AlexKokoschka/StepMother/v1-teensy/enclosure/design-your-own/StepMother1_Teensy_FitCheck.step

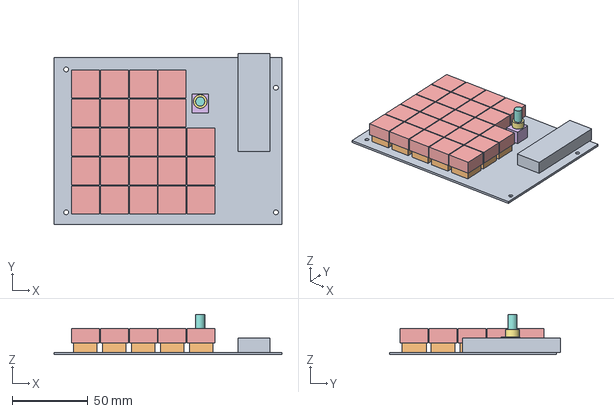
[picture p1: CAD file, 2026-11-03]
v1-teensy/enclosure/design-your-own/StepMother1_Teensy_FitCheck.step
150.0 x 112.5 x 26.6 mm
