AlexKokoschka/StepMother/v1-teensy/enclosure/print/StepMother1_Teensy_BottomPlate.step

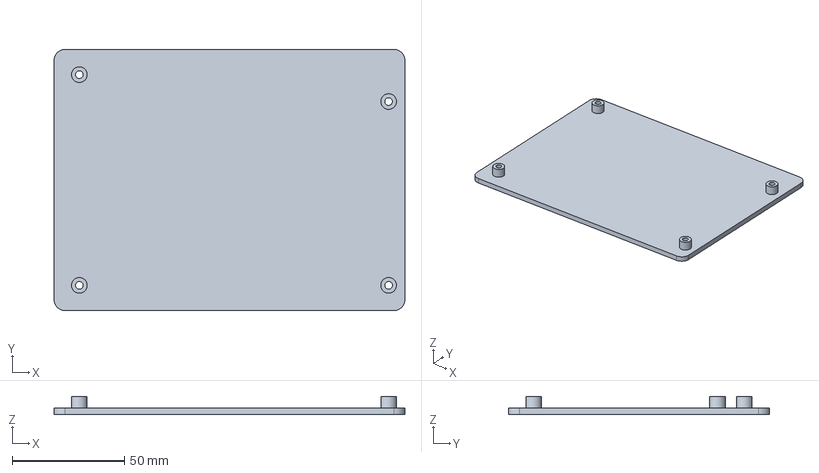
[picture p2: CAD file, 2026-11-03]
v1-teensy/enclosure/print/StepMother1_Teensy_BottomPlate.step
156.6 x 116.6 x 8.20 mm
