AlexKokoschka/StepMother/v1-teensy/enclosure/source/StepMother1_Teensy_Enclosure.FCStd

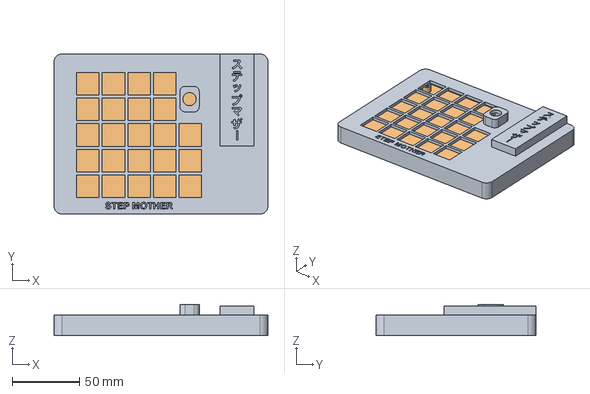
[picture p3: CAD file, 2026-11-03]
v1-teensy/enclosure/source/StepMother1_Teensy_Enclosure.FCStd
159.0 x 119.0 x 23.1 mm
BottomPlate
