AlexKokoschka/StepMother/v1-teensy/pcb/3_documentation/StepMother1_3D_2026-11-01.step

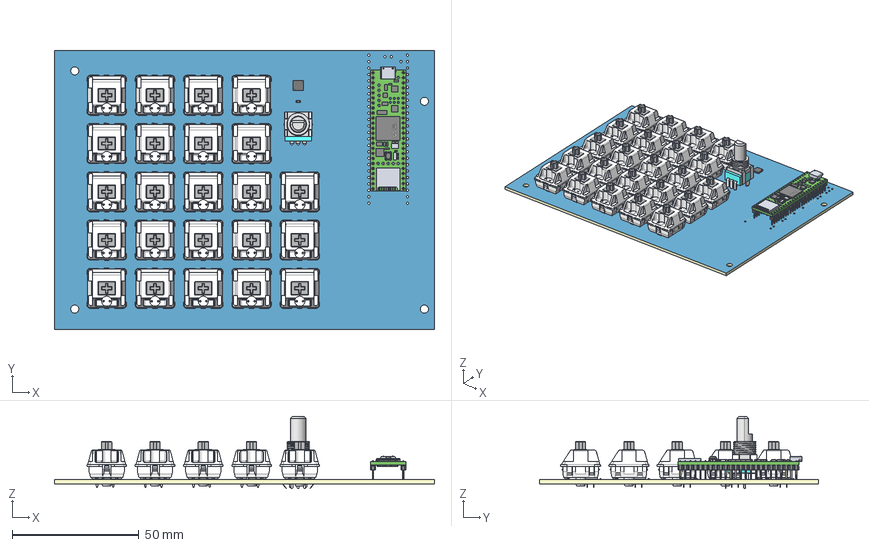
[picture p4: CAD file, 2026-11-03]
v1-teensy/pcb/3_documentation/StepMother1_3D_2026-11-01.step
150.0 x 110.0 x 28.5 mm
Board~ziuG
TopCopper~ziuG
BottomCopper~ziuG
TopSilkscreen~ziuG
BottomSilkscreen~ziuG
TopFpcStiffener~ziuG
BottomFpcStiffener~ziuG
R0603~R0603~ziuG
SOD-123_L2.7-W1.6-LS3.7-FD~SOD-123_L2.7-W1.6-LS3.7-FD~ziuG x 23
QFN-28_L4.0-W4.0-P0.40-BL-EP~QFN-28_L4.0-W4.0-H0.9-P0.40-BL-EP~ziuG
LED0402-R-RD~LED0402_L1.0-W0.5-H0.4~ziuG x 20
RES-ADJ-TH_RK09L1140A5P~RES-ADJ-TH_RK09L1140A5P~ziuG
KEY-TH_CPG151101D06~KEY-TH_CPG151101D06~ziuG x 23
TEENSY4.1 - KB~COMM-TH_TEENSY4.1COPY~ziuG
