AlexKokoschka/StepMother/v2-rp2040/enclosure/source/StepMother2_RP2040_Enclosure.FCStd

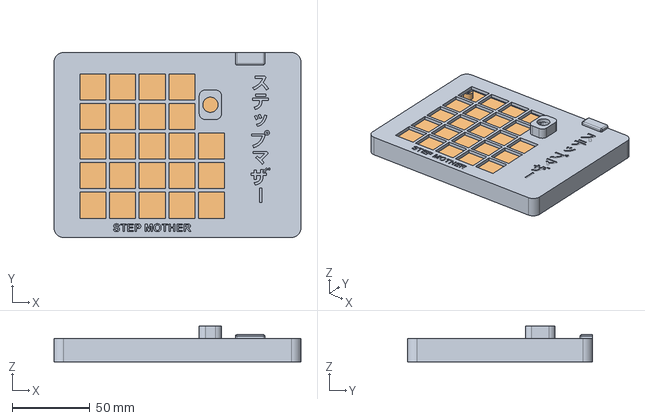
[picture p5: CAD file, 2026-11-12]
v2-rp2040/enclosure/source/StepMother2_RP2040_Enclosure.FCStd
159.0 x 119.0 x 23.1 mm
BottomPlate
