AlexKokoschka/StepMother/v2-rp2040/pcb/3_documentation/StepMother2_3D_2026-11-12.step

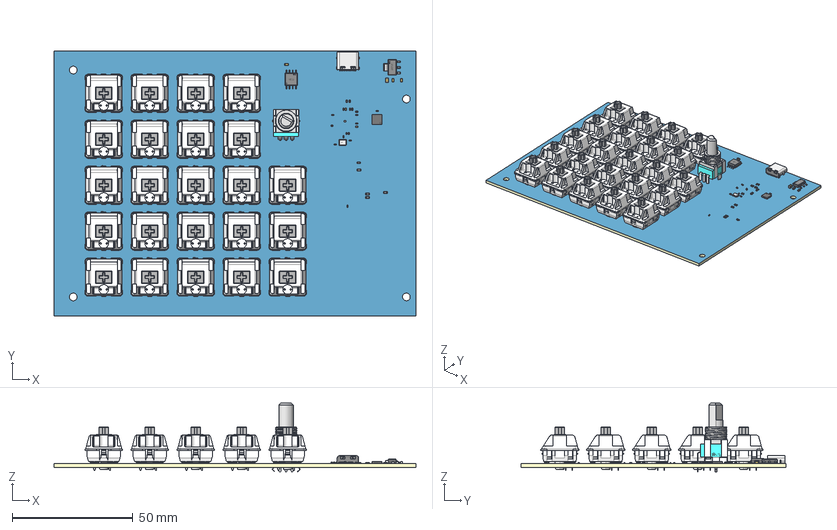
[picture p6: CAD file, 2026-11-12]
v2-rp2040/pcb/3_documentation/StepMother2_3D_2026-11-12.step
150.0 x 110.0 x 28.5 mm
Board~VF1d
TopCopper~VF1d
BottomCopper~VF1d
TopSilkscreen~VF1d
BottomSilkscreen~VF1d
TopFpcStiffener~VF1d
BottomFpcStiffener~VF1d
LQFN-56_L7.0-W7.0-P0.4-EP~LQFN-56_L7.0-W7.0-P0.4-EP~VF1d
KEY-TH_CPG151101D06~KEY-TH_CPG151101D06~yfCF x 23
C0603~C0603_L1.6-W0.8-H0.8~tLiC x 3
C0805~C0805_L2.0-W1.3-H1.3~WK5H
LED0402-R-RD~LED0402_L1.0-W0.5-H0.4~oqK9 x 20
SOD-123_L2.7-W1.6-LS3.7-FD~SOD-123_L2.7-W1.6-LS3.7-FD~p6Gi x 23
C0402~C0402_L1.0-W0.5-H0.5~t2Ha x 15
R0603~R0603~kR0k x 5
R0402~R0402_L1.0-W0.5-H0.4~Sbx4 x 4
CRYSTAL-SMD_4P-L3.2-W2.5-BL~CRYSTAL-SMD_4P-L3.2-W2.5-BL~g01I
SOT-223-3_L6.5-W3.4-P2.30-LS7.0-BR~SOT-223-4P_L6.5-W3.5-H1.6-LS7.0-P2.30~qlD3
USB-C_SMD-TYPE-C-31-M-12_1~USB-C_SMD-TYPE-C-31-M-12_1~Xcjv
RES-ADJ-TH_RK09L1140A5P~RES-ADJ-TH_RK09L1140A5L~RHhM
SOIC-8_L5.3-W5.3-P1.27-LS8.0-BL~SOIC-8_L5.3-W5.3-H1.9-LS7.9-P1.27~I64y
QFN-28_L4.0-W4.0-P0.40-BL-EP~QFN-28_L4.0-W4.0-H0.9-P0.40-BL-EP~uROi
