AlexKokoschka/StepMother/v1-teensy/enclosure/print/StepMother1_Teensy_Shell.step

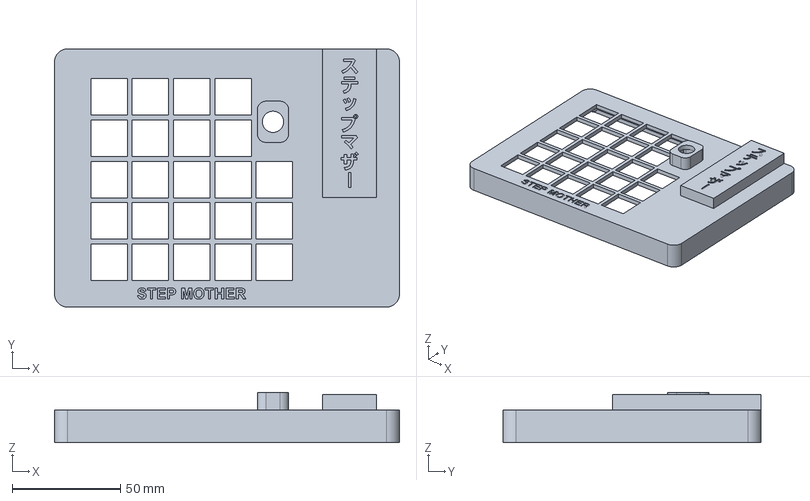
[picture p7: CAD file, 2026-11-03]
v1-teensy/enclosure/print/StepMother1_Teensy_Shell.step
159.0 x 119.0 x 23.1 mm
