AlexKokoschka/StepMother/v2-rp2040/enclosure/print/StepMother2_RP2040_Shell.step

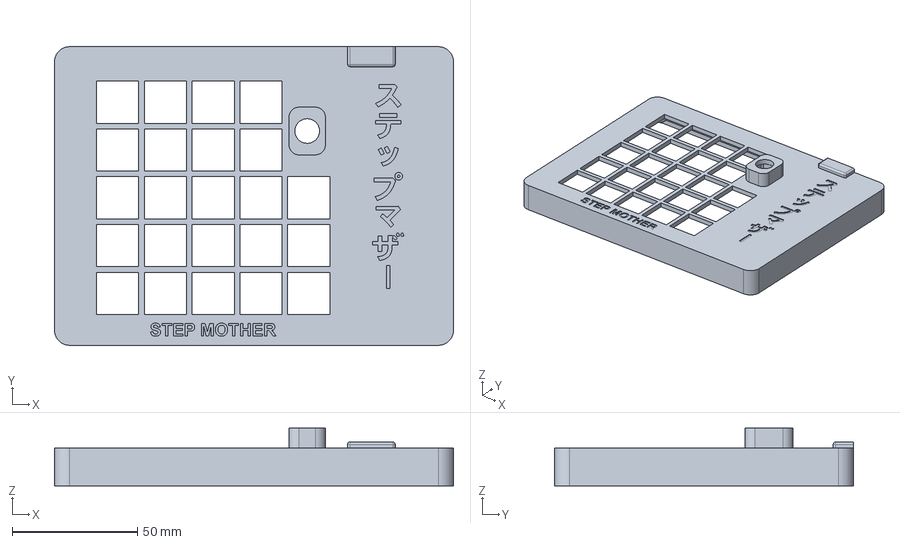
[picture p8: CAD file, 2026-11-12]
v2-rp2040/enclosure/print/StepMother2_RP2040_Shell.step
159.0 x 119.0 x 23.1 mm
