AlexKokoschka/StepMother/(list of files, cad)

Other CAD files:
v2-rp2040/enclosure/design-your-own/StepMother2_RP2040_FitCheck.step
v2-rp2040/enclosure/print/StepMother2_RP2040_BottomPlate.step
v1-teensy/enclosure/print/StepMother1_Teensy_BottomPlate.stl
v1-teensy/enclosure/print/StepMother1_Teensy_Shell.stl
v2-rp2040/enclosure/print/StepMother2_RP2040_BottomPlate.stl
v2-rp2040/enclosure/print/StepMother2_RP2040_Shell.stl
