AlexKokoschka/StepMother/v2-rp2040/pcb/3_documentation/StepMother2_PCB_Assembly_2026-11-12.pdf

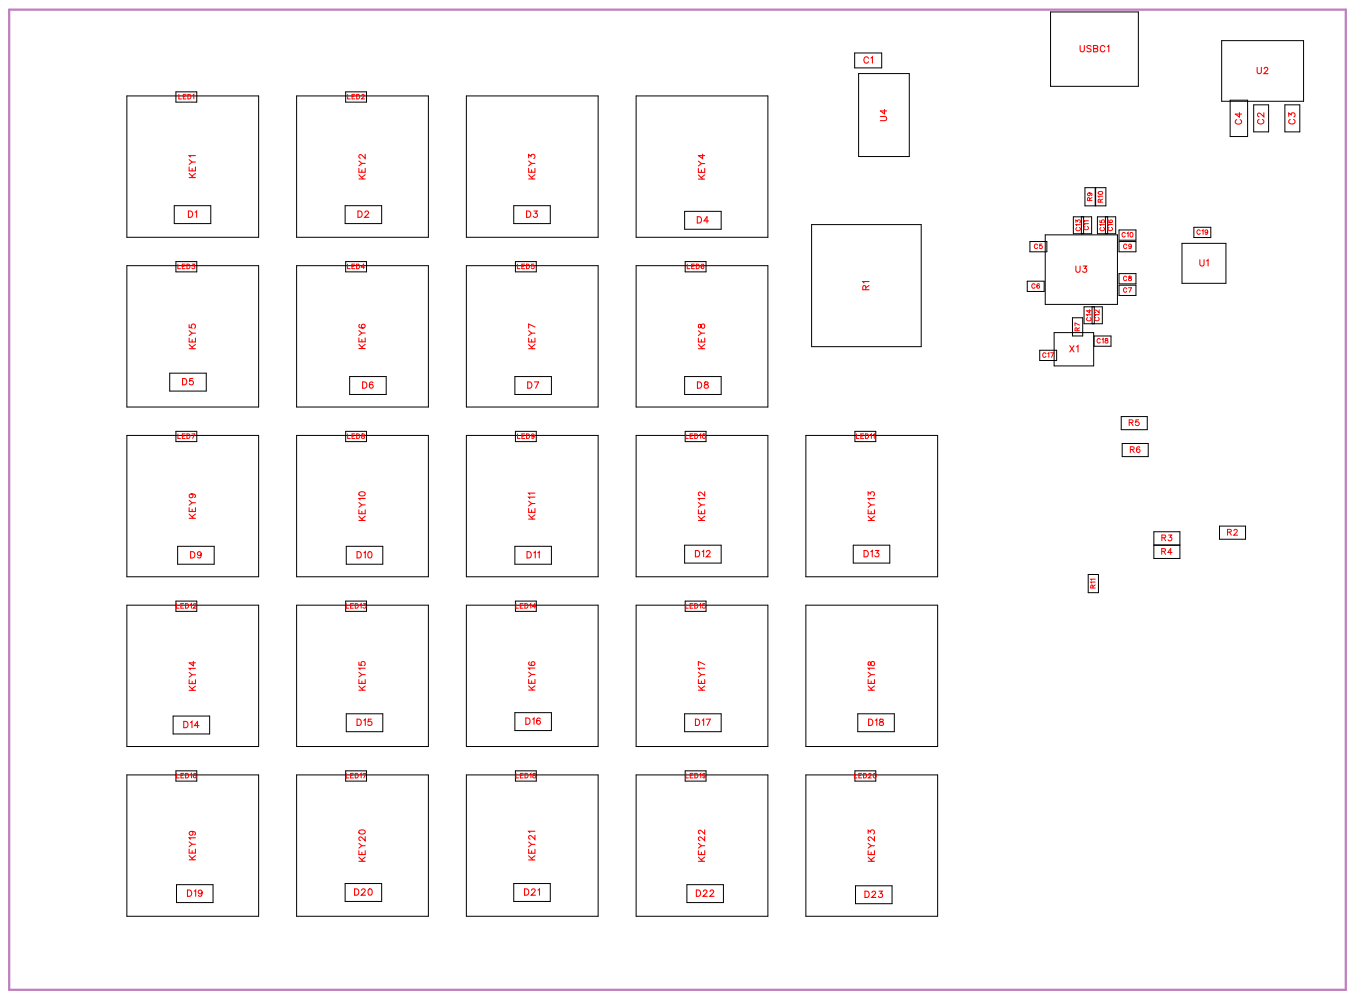
[picture p9: page 1]

No. | Quantity | Comment | Designator | Footprint | Value | Manufacturer Part | Manufacturer | Supplier Part | Supplier
1 | 1 | 100nF | C1 | C0603 | 100nF | CC0603KRX 7R9BB104 | YAGEO(国巨 ) | C14663 | LCSC
2 | 1 | 1uF | C2 | C0603 | 1uF | CL10A105KB 8NNNC | SAMSUNG( ) 三星 | C15849 | LCSC
3 | 1 | 10uF | C3 | C0603 | 10uF | CL10A106KP 8NNNC | SAMSUNG( 三星 ) | C19702 | LCSC
4 | 1 | 22uF | C4 | C0805 | 22uF | CL21A226M AQNNNE | SAMSUNG( 三星 ) | C45783 | LCSC
5 | 11 | 100nF | C5,C6,C7,C8,C9,C10,C11, C12,C13,C14,C19 | C0402 | 100nF | CL05B104K O5NNNC | SAMSUNG( 三星 ) | C1525 | LCSC
6 | 2 | 1uF | C15,C16 | C0402 | 1uF | CL05A105KA 5NQNC | SAMSUNG( ) 三星 | C52923 | LCSC
7 | 2 | 15pF | C17,C18 | C0402 | 15pF | 0402CG150J 500NT | FH(风华 ) | C1548 | LCSC
8 | 23 | 1N4148W | D1,D2,D3,D4,D5,D6,D7,D8, D9,D10,D11,D12,D13,D14, D15,D16,D17,D18,D19,D20 ,D21,D22,D23 | SOD-123_L2 .7-W1.6-LS3. 7-FD | | 1N4148W | HXY MOSFE T(华轩阳电子 ) | C5345962 | LCSC
9 | 23 | CPG151101 D06 | KEY1,KEY2,KEY3,KEY4,K EY5,KEY6,KEY7,KEY8,KE Y9,KEY10,KEY11,KEY12,K EY13,KEY14,KEY15,KEY16 ,KEY17,KEY18,KEY19,KEY 20,KEY21,KEY22,KEY23 | KEY-TH_CP G151101D06 | | CPG151101 D06 | HanElectricit y(瀚源 ) | C49234237 | LCSC
10 | 20 | YLED0402R | LED1,LED2,LED3,LED4,LE D5,LED6,LED7,LED8,LED9 ,LED10,LED11,LED12,LED 13,LED14,LED15,LED16,LE D17,LED18,LED19,LED20 | LED0402-R-RD | | YLED0402R | YONGYUTAI (永裕泰) | C21260817 | LCSC
11 | 1 | 10k | R1 | RES-ADJ-TH _RK09L1140 A5P | 10k | RK09L1140A 5L | ALPSALPIN E(阿尔卑斯阿 尔派 ) | C7419101 | LCSC
12 | 1 | 20k | R2 | R0603 | 20k | 0603WAF20 02T5E | UNI-ROYAL( ) 厚声 | C4184 | LCSC
13 | 2 | 4.7k | R3,R4 | R0603 | 4.7k | 0603WAF47 01T5E | UNI-ROYAL( ) 厚声 | C23162 | LCSC
14 | 2 | 5.1k | R5,R6 | R0603 | 5.1k | 0603WAF51 01T5E | UNI-ROYAL( 厚声 ) | C23186 | LCSC
15 | 1 | 1k | R7 | R0402 | 1k | 0402WGF10 01TCE | UNI-ROYAL( 厚声 ) | C11702 | LCSC
16 | 2 | 27 | R9,R10 | R0402 | 27 | 0402WGJ02 70TCE | UNI-ROYAL( 厚声 ) | C25156 | LCSC
17 | 1 | 10k | R11 | R0402 | 10k | 0402WGF10 02TCE | UNI-ROYAL( ) 厚声 | C25744 | LCSC
18 | 1 | IS31FL3731-QFLS2-TR | U1 | QFN-28_L4.0 -W4.0-P0.40-BL-EP | | IS31FL3731-QFLS2-TR | ISSI(北京矽 成) | C191206 | LCSC

19 | 1 | AMS1117-3. 3 | U2 | SOT-223-3_L 6.5-W3.4-P2. 30-LS7.0-BR | | AMS1117-3. 3 | Advanced Monolithic Systems | C6186 | LCSC
20 | 1 | RP2040 | U3 | LQFN-56_L7. 0-W7.0-P0.4-EP | | RP2040 | Raspberry Pi(树莓派 ) | C2040 | LCSC
21 | 1 | W25Q16JVS SIQ | U4 | SOIC-8_L5.3 -W5.3-P1.27-LS8.0-BL | | W25Q16JVS SIQ | Winbond( 华 ) 邦 | C131025 | LCSC
22 | 1 | TYPE-C-31-M-12 | USBC1 | USB-C_SMD -TYPE-C-31-M-12_1 | | TYPE-C-31-M-12 | 韩国韩荣 | C165948 | LCSC
23 | 1 | 12MHz | X1 | CRYSTAL-S MD_4P-L3.2-W2.5-BL | 12MHz | ABM8-272-T 3 | ABRACON | C20625731 | LCSC

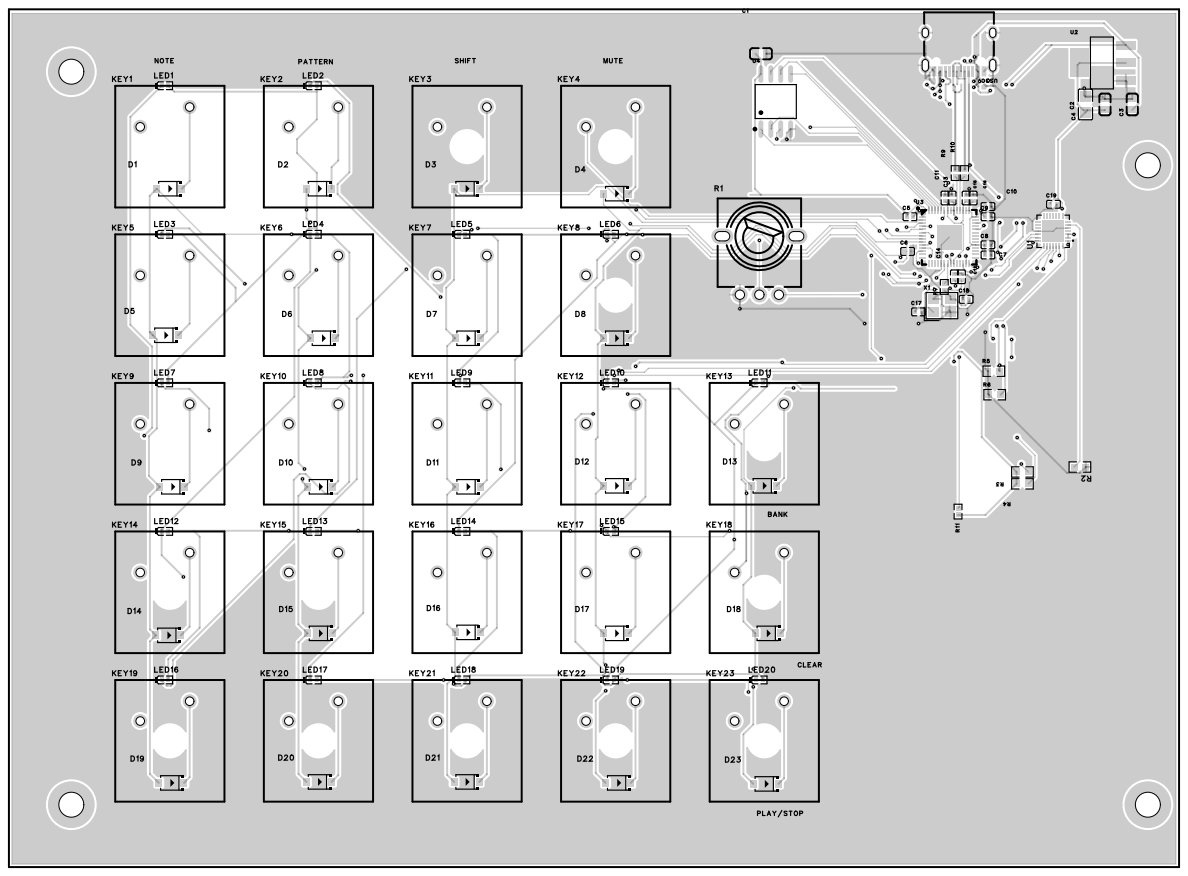
[picture p10: page 5]

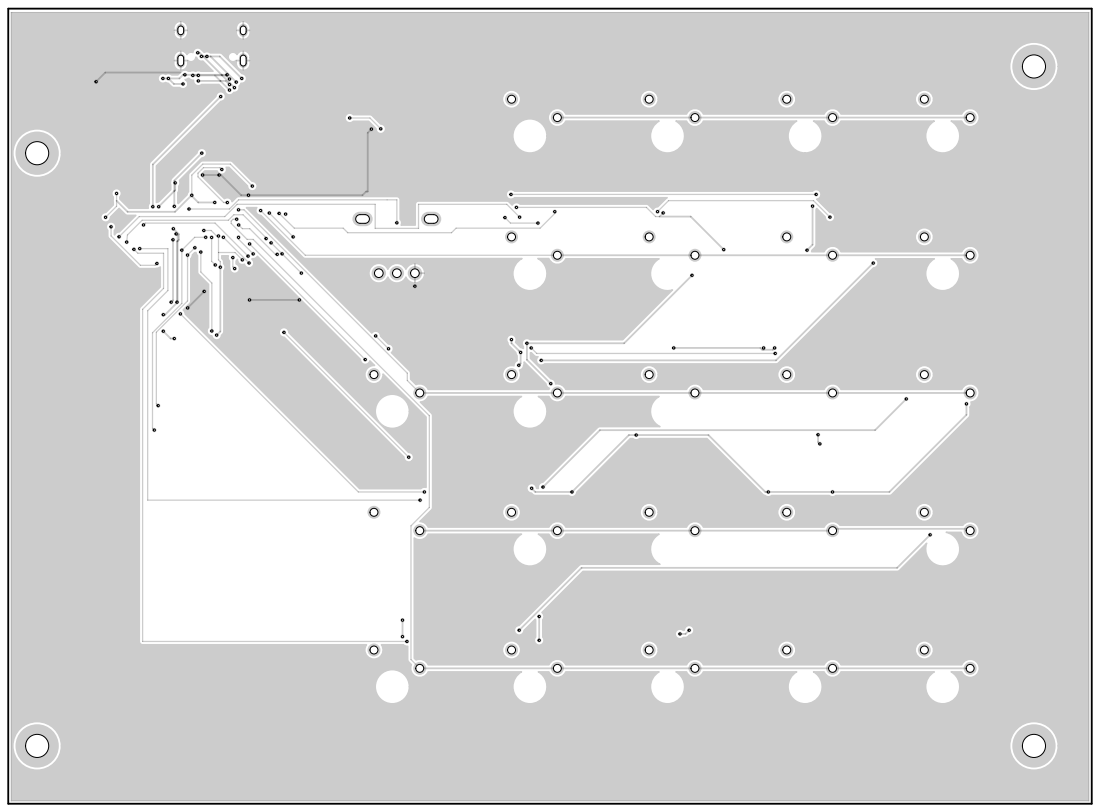
[picture p11: page 6]

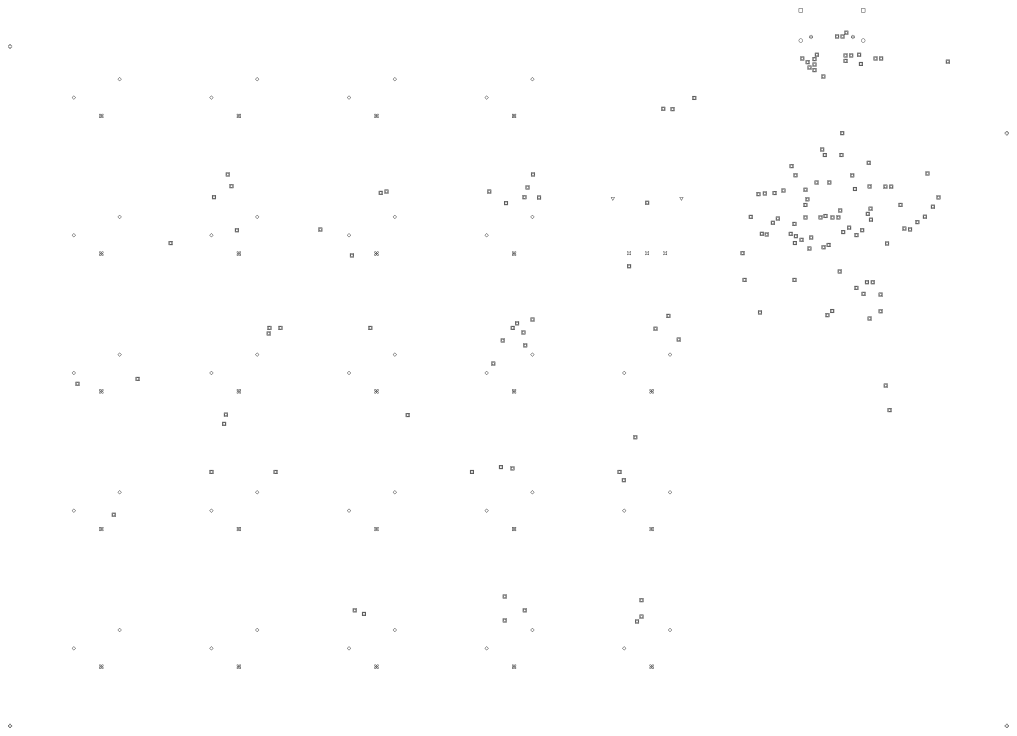
[picture p12: page 7]
