AlexKokoschka/StepMother/v2-rp2040/pcb/3_documentation/StepMother2_Schematic_2026-11-12.pdf

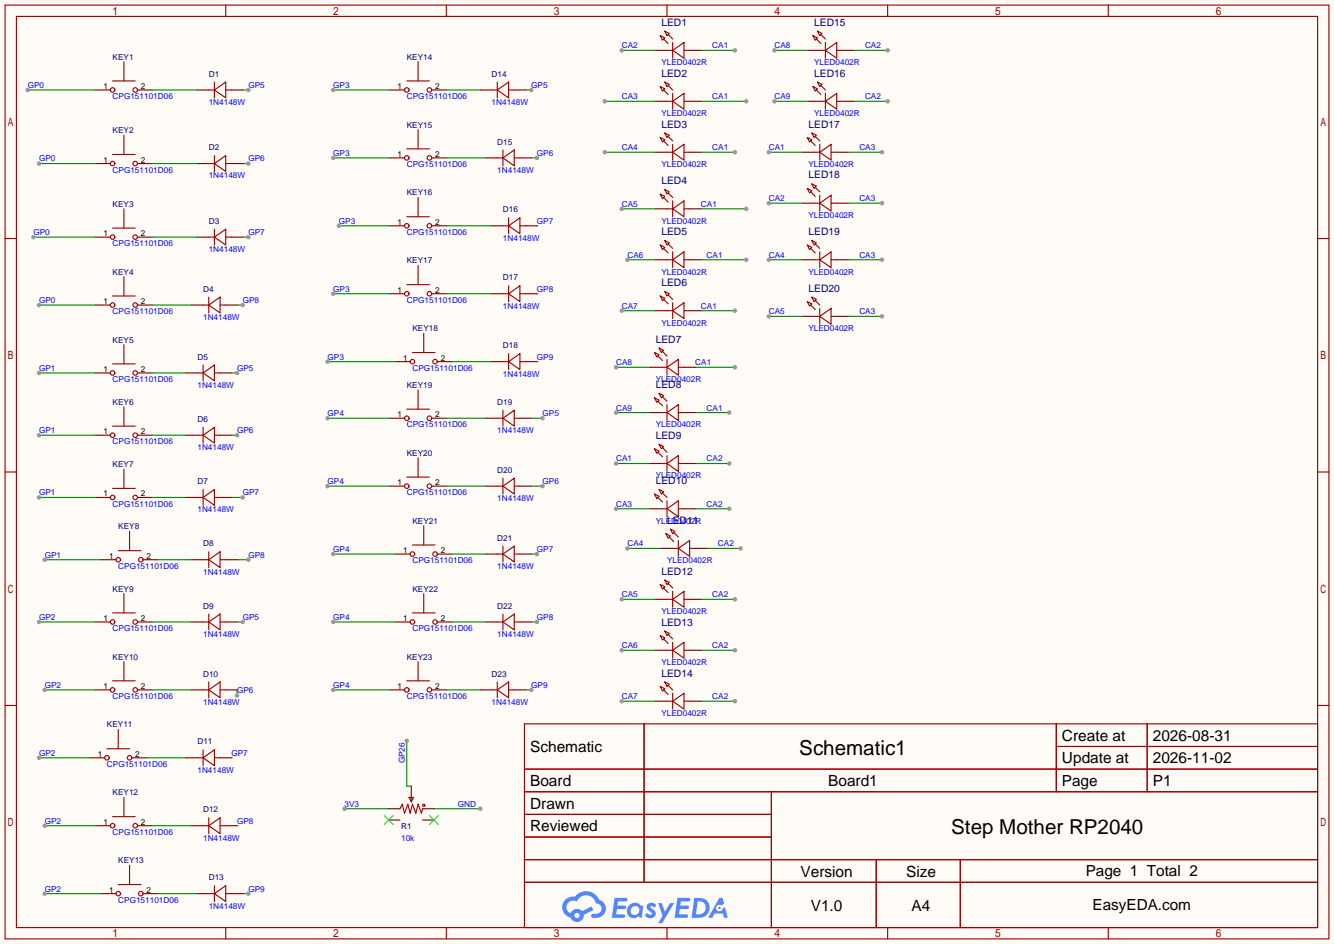
[picture p13: page 1]

Schematic | Schematic1 | Create at | 2026-08-31

Update at | 2026-11-02

Board | Board1 | Page | P1
Drawn | | Step Mother RP2040
Reviewed

Version | Size | Page 1 Total 2
V1.0 | A4 | EasyEDA.com

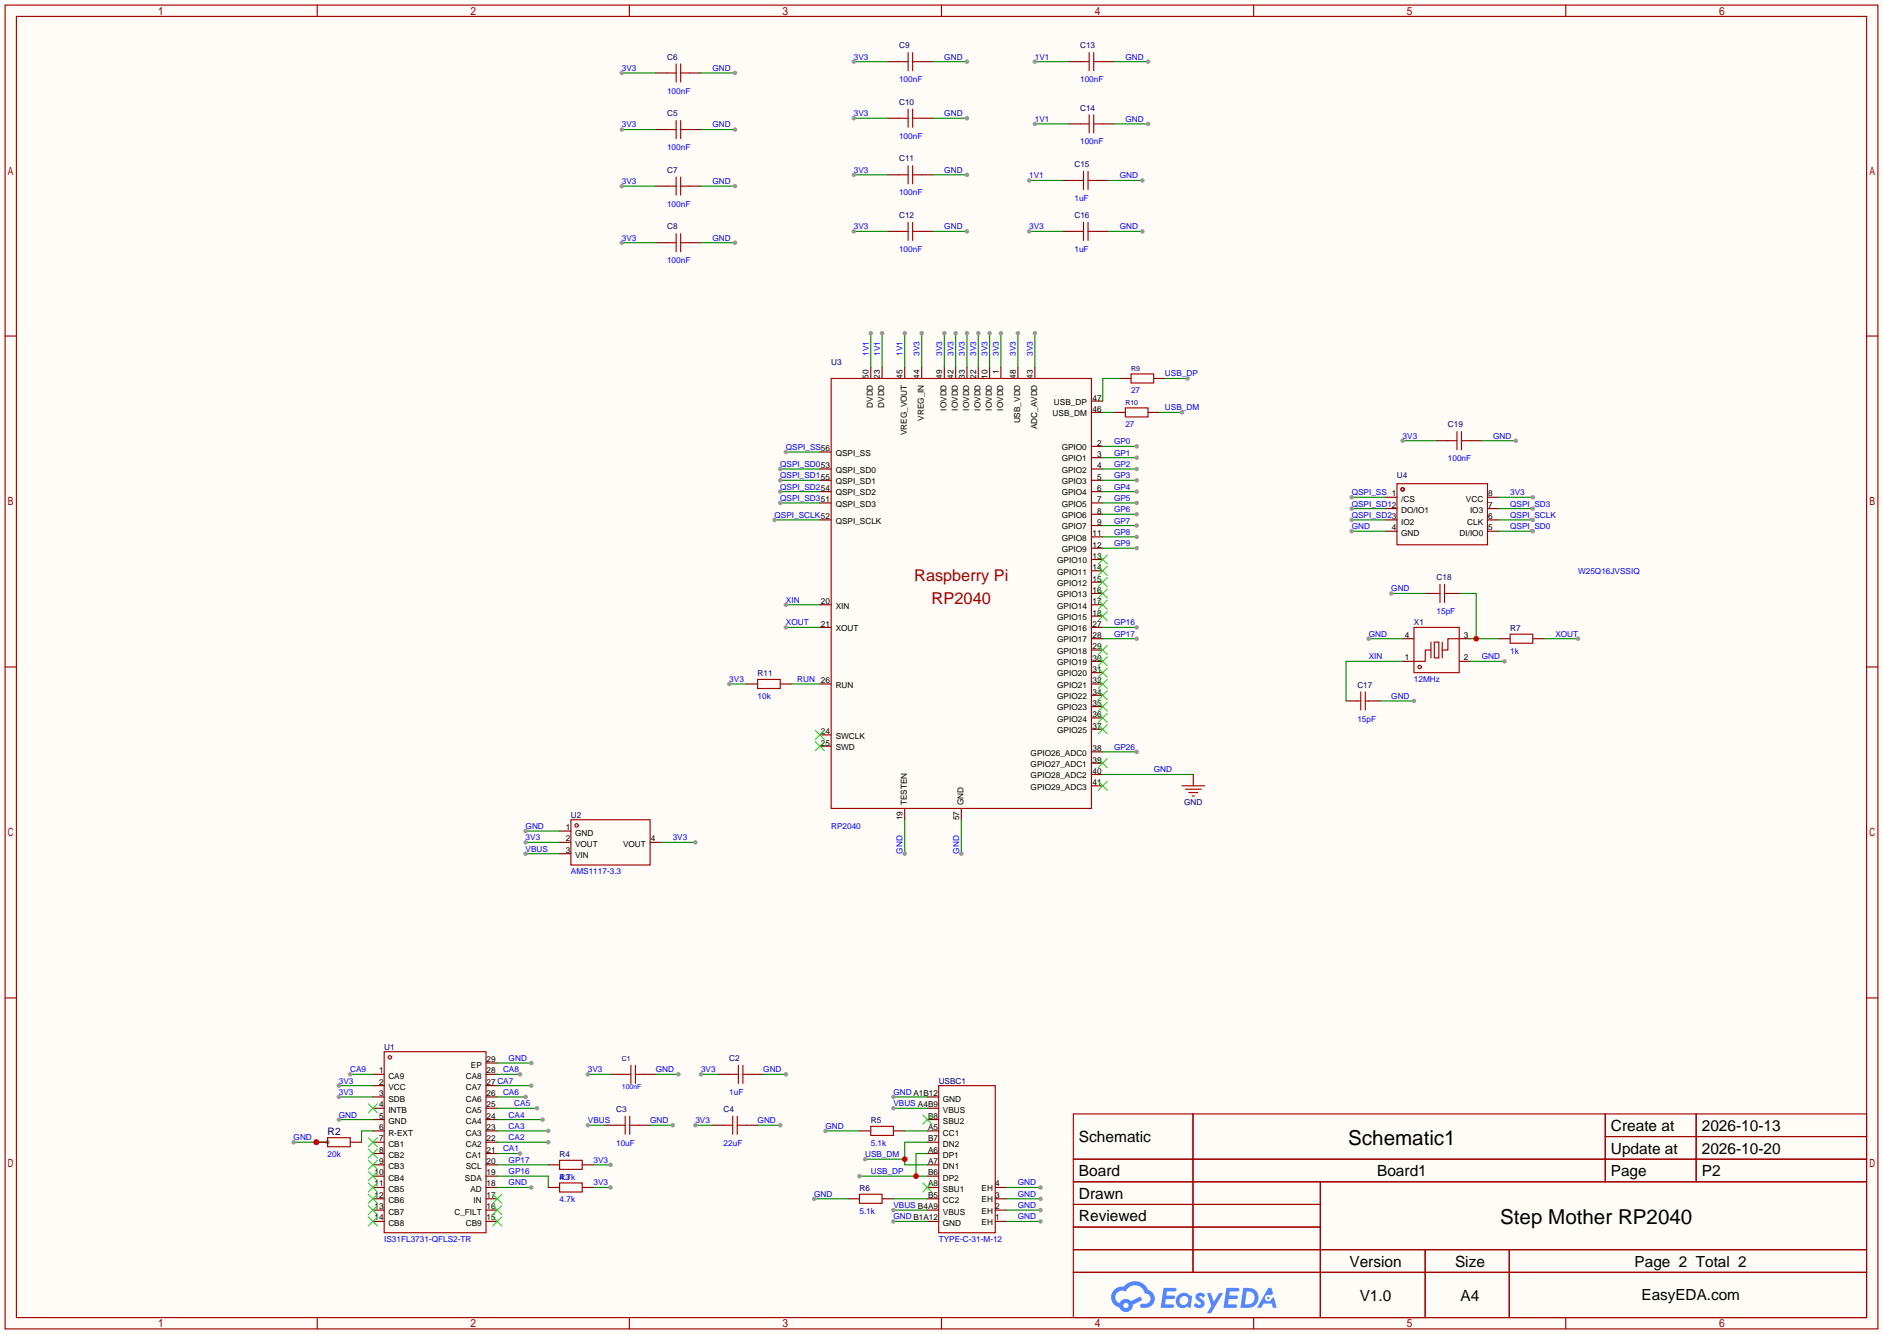
[picture p14: page 2]

Schematic | Schematic1 | Create at | 2026-10-13

Update at | 2026-10-20

Board | Board1 | Page | P2
Drawn | | Step Mother RP2040
Reviewed

Version | Size | Page 2 Total 2
V1.0 | A4 | EasyEDA.com
