AlexKokoschka/StepMother/v1-teensy/pcb/3_documentation/StepMother1_PCB_Assembly_2026-11-01.pdf

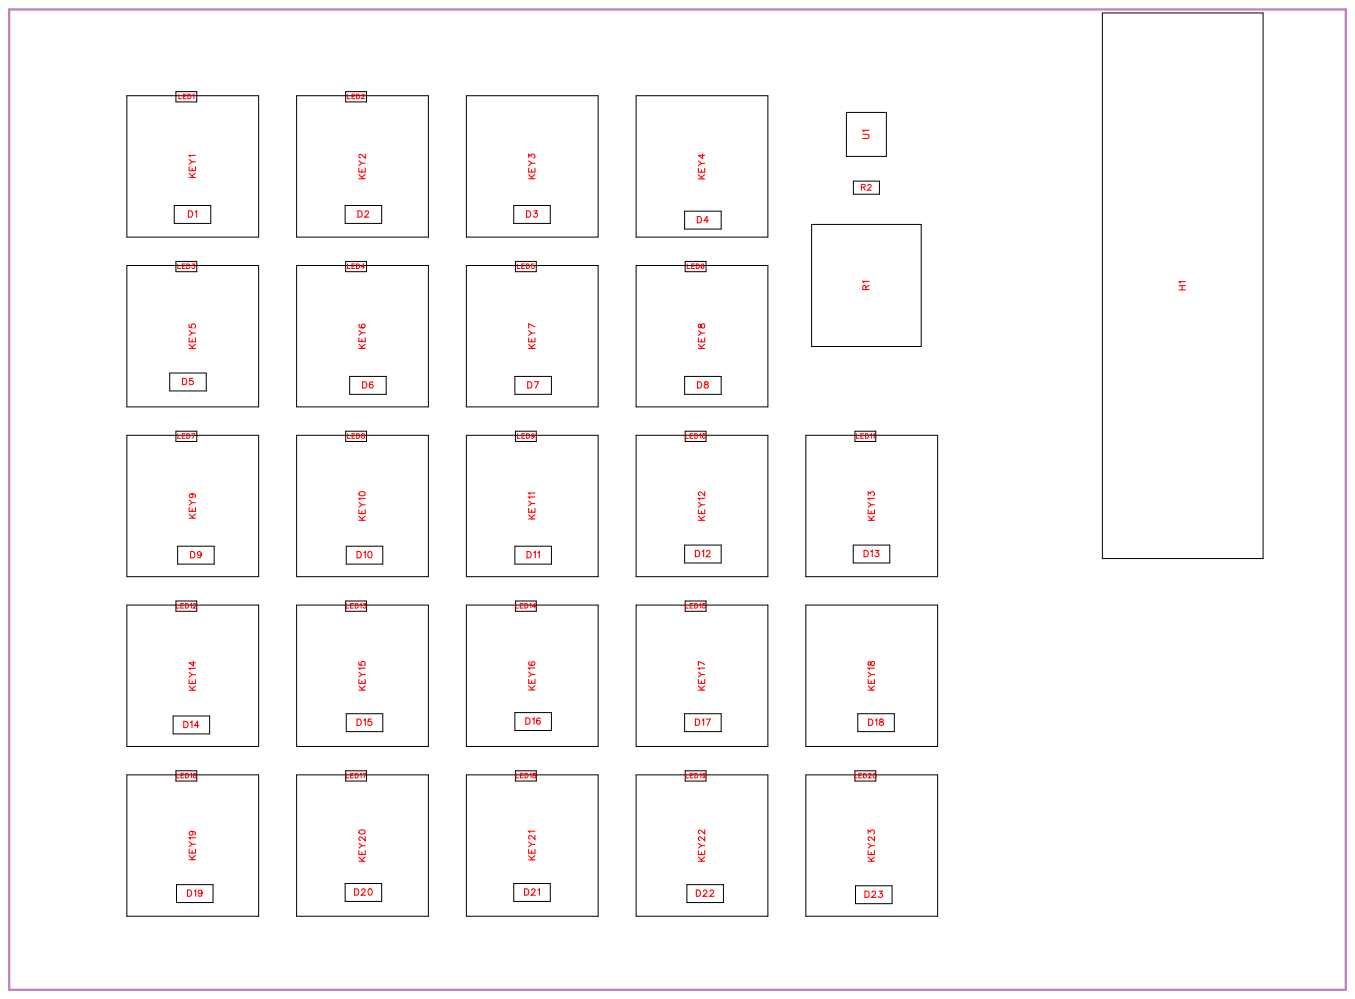
[picture p15: page 1]

No. | Quantity | Comment | Designator | Footprint | Value | Manufacturer Part | Manufacturer | Supplier Part | Supplier
1 | 23 | 1N4148W | D1,D2,D3,D4,D5,D6,D7,D8, D9,D10,D11,D12,D13,D14, D15,D16,D17,D18,D19,D20 ,D21,D22,D23 | SOD-123_L2 .7-W1.6-LS3. 7-FD | | 1N4148W | HXY MOSFE T(华轩阳电子 ) | C5345962 | LCSC
2 | 1 | TEENSY4.1 -KB COPY | H1 | TEENSY4.1 -KB | Teensy 4.1 | Teensy4.1 | PJRC
3 | 23 | CPG151101 D06 | KEY1,KEY2,KEY3,KEY4,K EY5,KEY6,KEY7,KEY8,KE Y9,KEY10,KEY11,KEY12,K EY13,KEY14,KEY15,KEY16 ,KEY17,KEY18,KEY19,KEY 20,KEY21,KEY22,KEY23 | KEY-TH_CP G151101D06 | | CPG151101 D06 | HanElectricit y(瀚源) | C49234237 | LCSC
4 | 20 | YLED0402R | LED1,LED2,LED3,LED4,LE D5,LED6,LED7,LED8,LED9 ,LED10,LED11,LED12,LED 13,LED14,LED15,LED16,LE D17,LED18,LED19,LED20 | LED0402-R-RD | | YLED0402R | YONGYUTAI (永裕泰) | C21260817 | LCSC
5 | 1 | 50k | R1 | RES-ADJ-TH _RK09L1140 A5P | 50k | RK09L1140A 5P | ALPSALPIN E(阿尔卑斯阿 尔派) | C231764 | LCSC
6 | 1 | 20k | R2 | R0603 | 20k | 0603WAF20 02T5E | UNI-ROYAL( 厚声) | C4184 | LCSC
7 | 1 | IS31FL3731-QFLS2-TR | U1 | QFN-28_L4.0 -W4.0-P0.40-BL-EP | | IS31FL3731-QFLS2-TR | ISSI(美国芯 成) | C191206 | LCSC

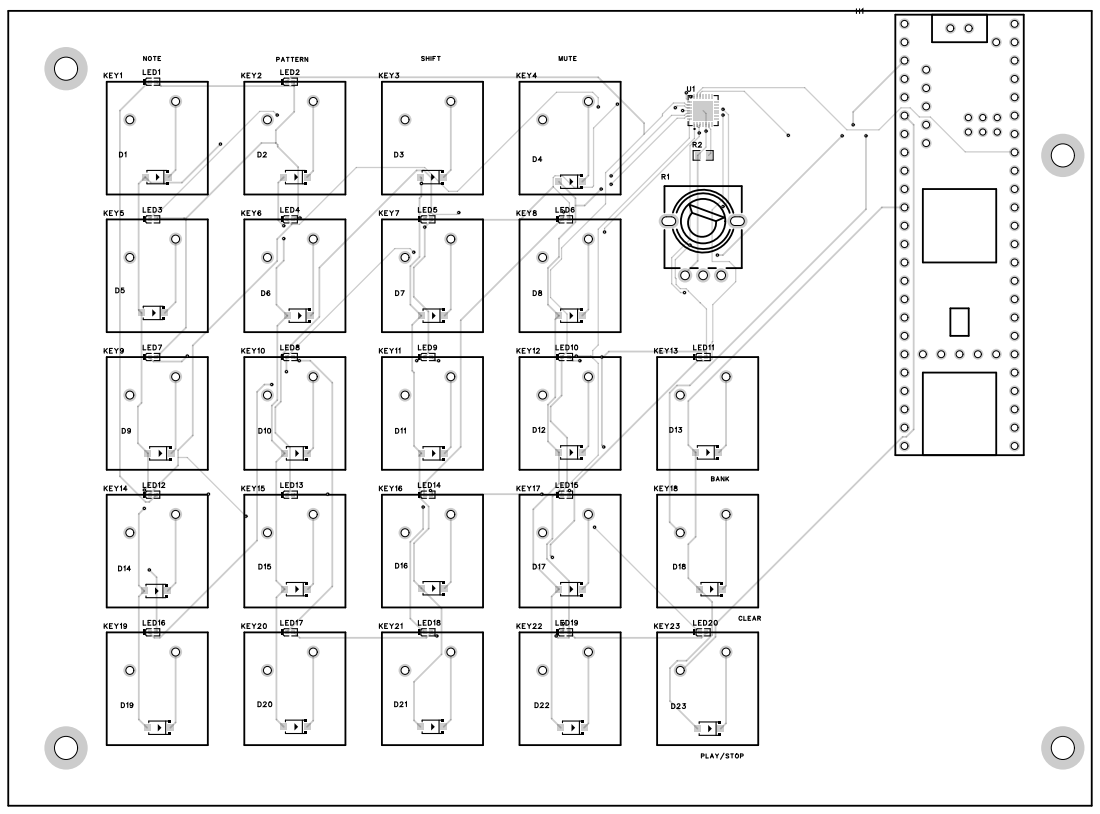
[picture p16: page 4]

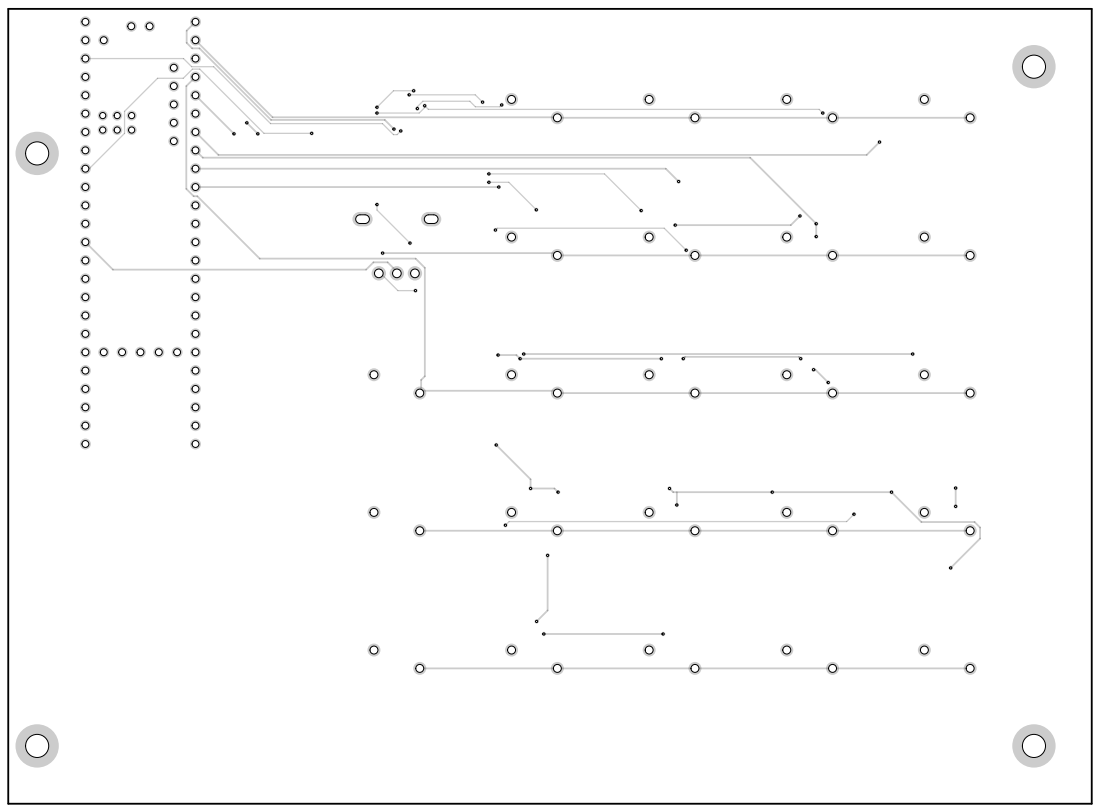
[picture p17: page 5]

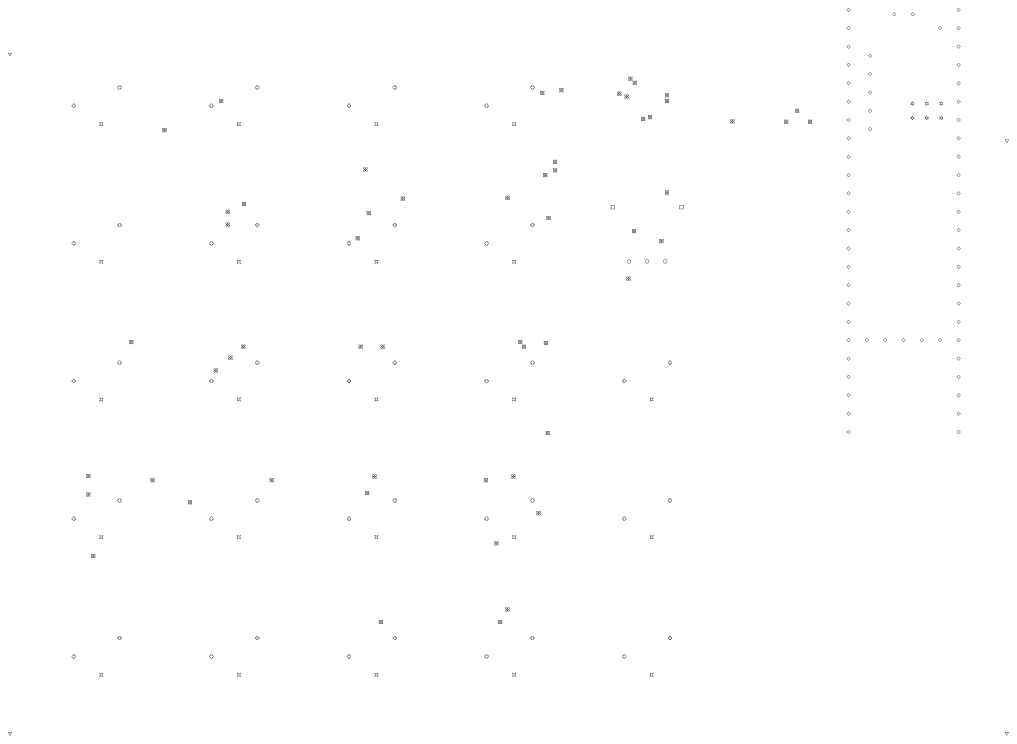
[picture p18: page 6]
