AlexKokoschka/StepMother/v1-teensy/pcb/3_documentation/StepMother1_Schematic_2026-11-01.pdf

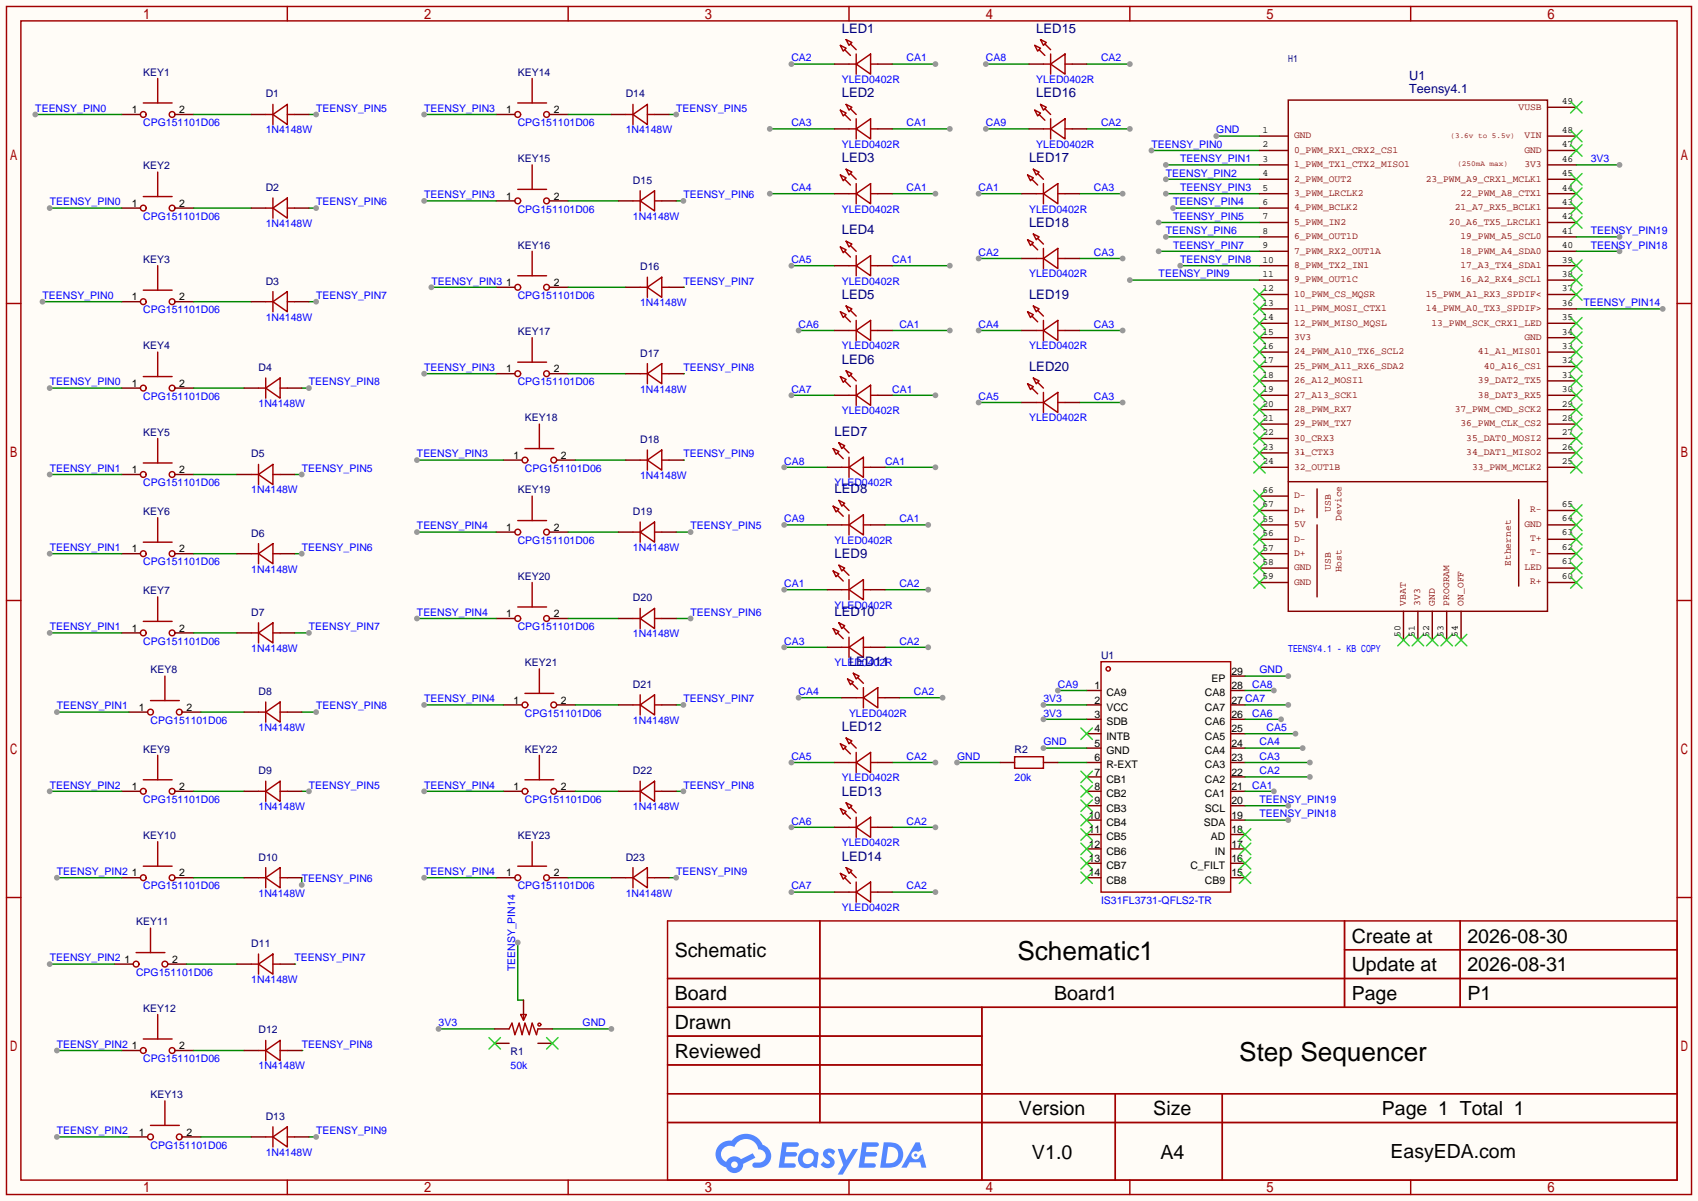
[picture p19: page 1]

Schematic | Schematic1 | Create at | 2026-08-30

Update at | 2026-08-31

Board | Board1 | Page | P1
Drawn | | Step Sequencer
Reviewed

Version | Size | Page 1 Total 1
V1.0 | A4 | EasyEDA.com
