AlexKokoschka/StepMother/(list of files, drawings)

Other design files:
v1-teensy/pcb/1_editable_design/StepMother1_EasyEDA-Pro-V2_2026-11-01.epro
v2-rp2040/pcb/1_editable_design/StepMother2_EasyEDA-Pro-V2_2026-11-12.epro
