AlexKokoschka/StepMother/(commit log)

2026-11-03 Step Mother 1 (Teensy 4.1) hardware: PCB and enclosure
    Moved from the StepDaddy repository. CERN-OHL-S-2.0.
    [StepMother1_BOM_2026-11-01.csv, StepMother1_EasyEDA-Pro-V2_2026-11-01.epro, StepMother1_PickAndPlace_2026-11-01.csv, StepMother1_Teensy_BottomPlate.step, StepMother1_Teensy_BottomPlate.stl, StepMother1_Teensy_Enclosure.FCStd, StepMother1_Teensy_FitCheck.step, StepMother1_Teensy_Shell.step]
2026-11-03 Add the assembled-board 3D model (STEP)
    [StepMother1_3D_2026-11-01.step]
2026-11-12 Step Mother 2 (RP2040) hardware: PCB and SLA enclosure
    - v2-rp2040/pcb: EasyEDA Pro project (.epro2 and .epro), Gerbers, BOM,
    pick-and-place, schematic and assembly PDFs, 3D model (RP2040 chip
    model missing from the export), README.
    - v2-rp2040/enclosure: SLA shell and bottom plate (STL, STEP), FreeCAD
    source, mechanical interface and FitCheck model, README.
    - Root README: why the RP2040, revisions table, comparison table.
    Claude-Session: https://claude.ai/code/session_01BBBwJZxfEygFComNtX8BsQ
    [StepMother2_3D_2026-11-12.step, StepMother2_BOM_2026-11-12.csv, StepMother2_EasyEDA-Pro-V2_2026-11-12.epro, StepMother2_PickAndPlace_2026-11-12.csv, StepMother2_RP2040_BottomPlate.step, StepMother2_RP2040_BottomPlate.stl, StepMother2_RP2040_Enclosure.FCStd, StepMother2_RP2040_FitCheck.step]
2026-11-12 Enclosure README: brass inserts and M3 x 12 screws
    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
